anujajoshi758/Astable-555-timer/README.md

# Astable-555-timer

[Report link](https://github.com/anujajoshi758/Astable-555-timer/blob/main/Board%201%20Report.pdf)
