anujajoshi758/Astable-555-timer/(list of files, drawings)

Other design files:
Lab2.PrjPcb
PCB1.PcbDoc
PCB2.PcbDoc
Sheet1.SchDoc
